handsomehhj/lcdc/epson/s1d13700/dev/branches/customer/truly/hw/brd/pdf/s1d13700_bom.xlsx

HOST I/F Revised: Thursday, August 09, 2012
HHJ-LCDC-2012001 Revision: 0.1
Bill Of Materials October 15,2012 15:38:38 | Page1
Item | Quantity | Reference | Part | Package
______________________________________________
Main |  | Main
1 | 1 | J1 | CON18 | TBD | 主机接口-插针
2 | 2 | R6,R7 | DNC | 0603
3 | 7 | R9,R12,R21,R41,R42,R43,R45 | DNC | 0603
4 | 27 | C1,C2,C7,C9,C11,C12,C13,C14,C15,C16,C17,C18,C19,C20, C21,C22,C23,C24,C25,C26,C27,C28,C29,C30,C31,C32,C33 | 0.1uF | 0603 |  | 电压/10V
5 | 2 | C8,C10 | 10uF | 1206 |  | 电压/10V
6 | 1 | D1 | LED_G | 0603 | LED Green | 绿色
7 | 2 | R1,R22 | 10K | 0603 |  | 精度？1%
8 | 3 | R2,R4,R5 | 33 | 0603 |  | 精度？1%
9 | 10 | R8,R10,R11,R13,R15,R16,R17,R18,R19,R20 | 0 | 0603
10 | 16 | R14,R23,R24,R25,R26,R27,R28,R29,R30,R31,R32,R33,R34, R35,R36,R37 | 4.7K | 0603 |  | 精度？1%
11 | 1 | U4 | SG8002 |  | 10MHz振荡器
12 | 1 | U6 | S1D13700
13 | 1 | U5 | TLV70012 | SOT23-5 | 1.2V LDO |  | Texas Itruments
14 | 1 | U7 | XC3S50A-4VQG100C | VQFP100 | FPGA 100 pin |  | Xilinx Inc
15 | 1 | U8 | SST25VF010 | SOIC-8 | Flash |  | MICROCHIP
3V/5V I/F
16 | 2 | U1,U2 | SN74AC245 | TSSOP20 |  |  | Texas Itruments
17 | 1 | U3 | LM1117-3.3V | SOT223 |  |  | National Semiconductor
18 | 2 | C3,C5 | 10uF | 1206 |  | 电压？10V
19 | 2 | C4,C6 | 0.1uF | 0603 |  | 10V
20 | 1 | R3 | 0 | 0603
Backlight
21 | 1 | L1 | 10uH | 1210 |  | 绕线
22 | 3 | R38,R39,R40 | 1.1 | 0603 |  | 精度？1%
23 | 2 | C36,C37 | 4.7uF | 1206 |  | 电压？10V
24 | 1 | D2 | MBR0530T1G | SOD123 |  |  | ON Semiconductor
25 | 1 | U9 | SP1072 | SOT123-6
26 | 1 | C34 | 0.1uF | 0603 |  | 电压？10V
27 | 1 | J4 | CON6 | TBD | BackLight I/F
28 | 1 | J3 | TM057KDH01 | TBD | LCD I/F
