handsomehhj/lcdc/epson/s1d13700/dev/branches/customer/truly/hw/brd/pdf/s1d13700.pdf

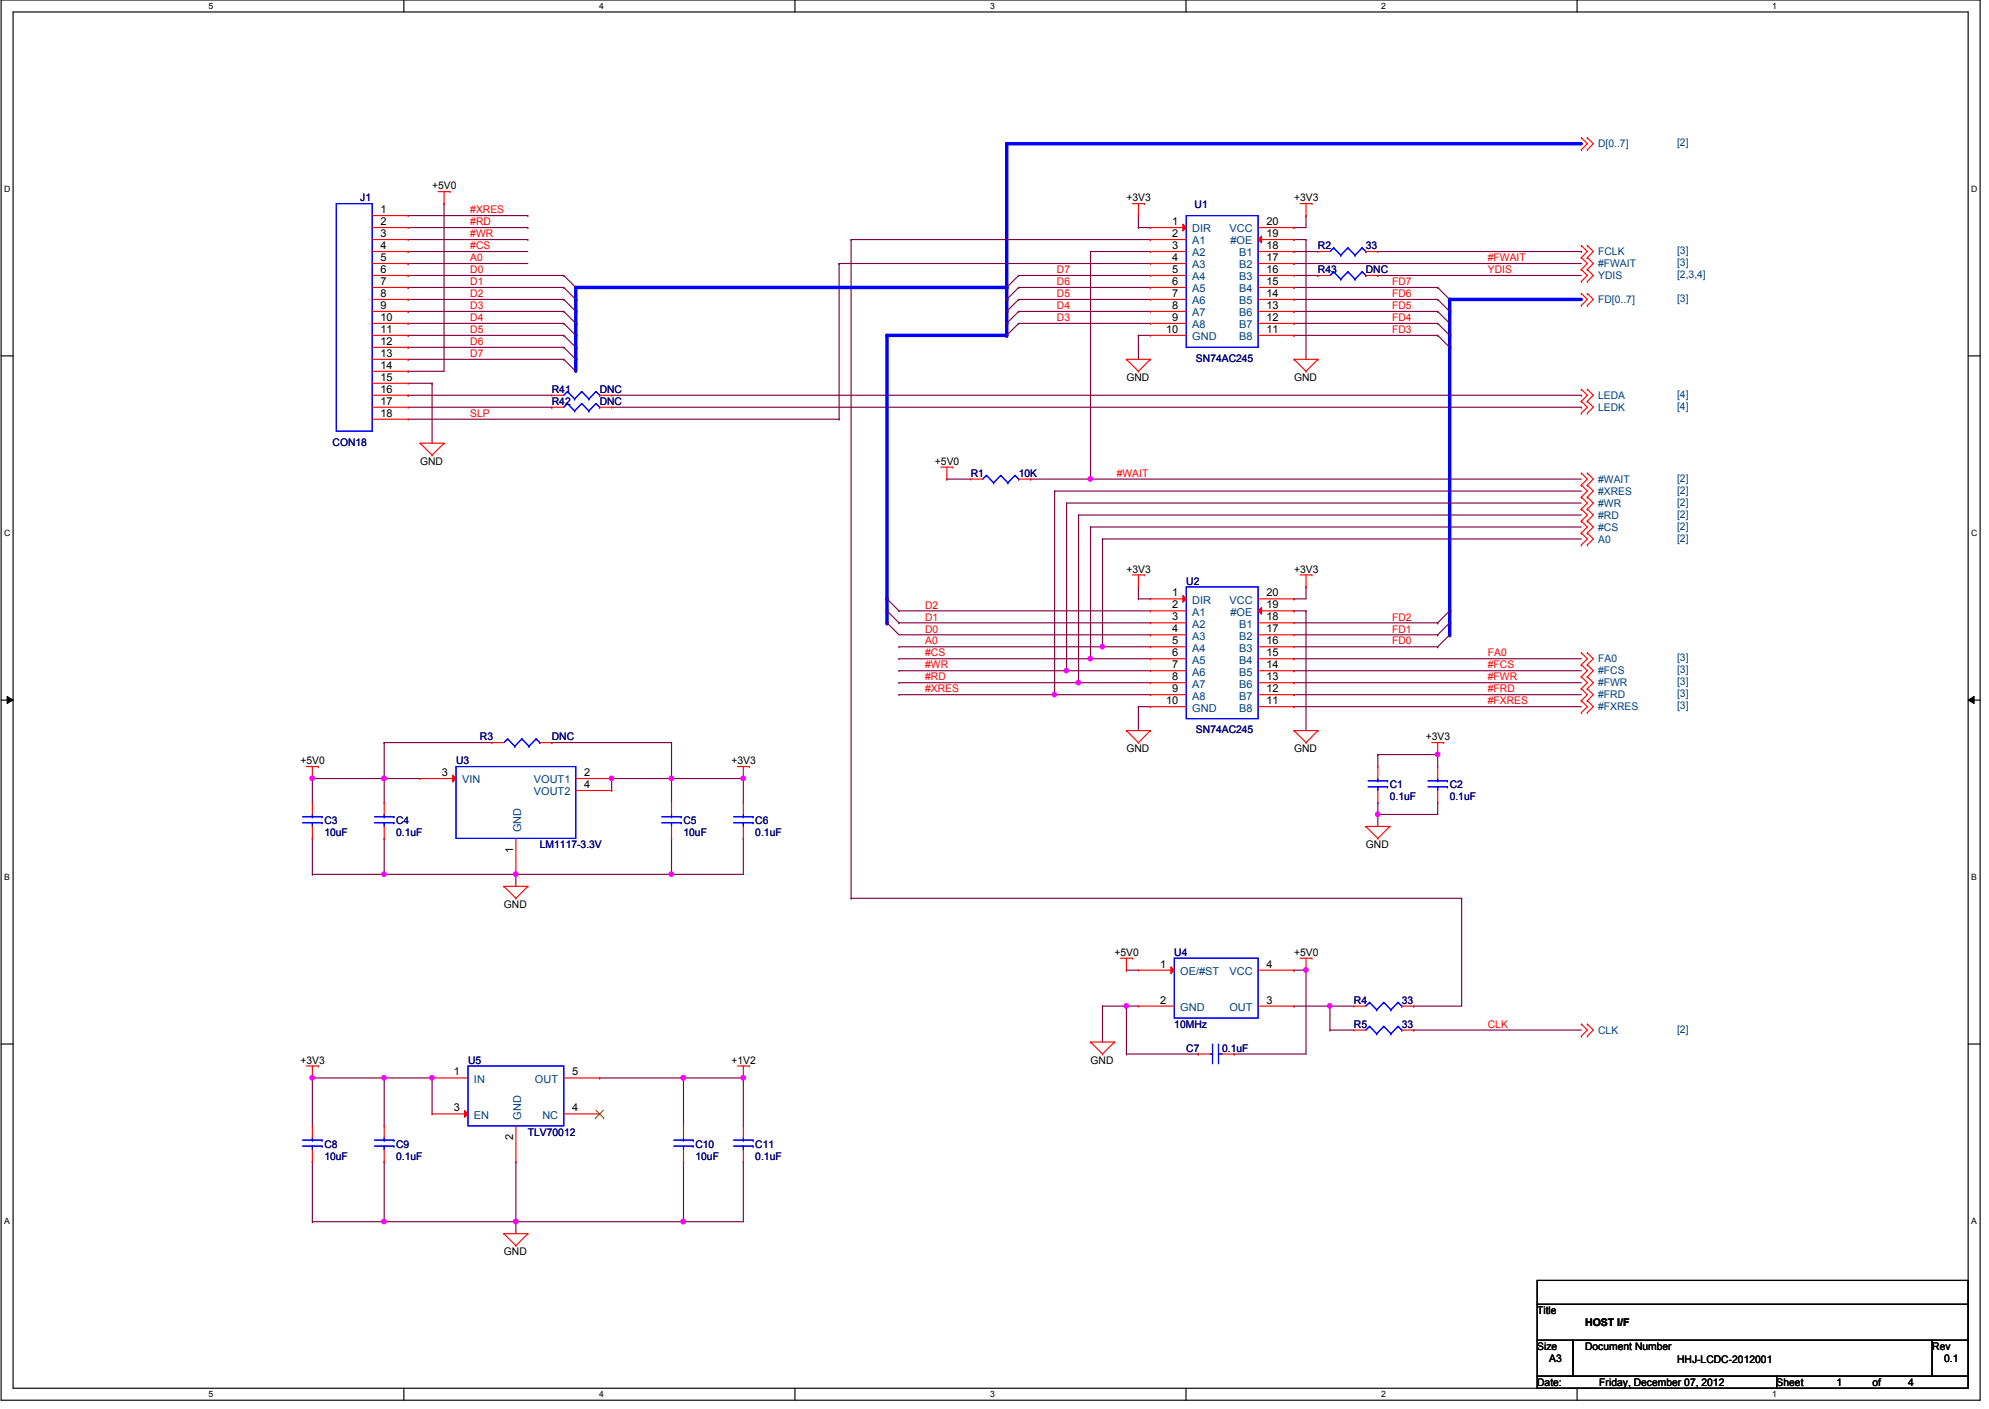
[picture p1: page 1]

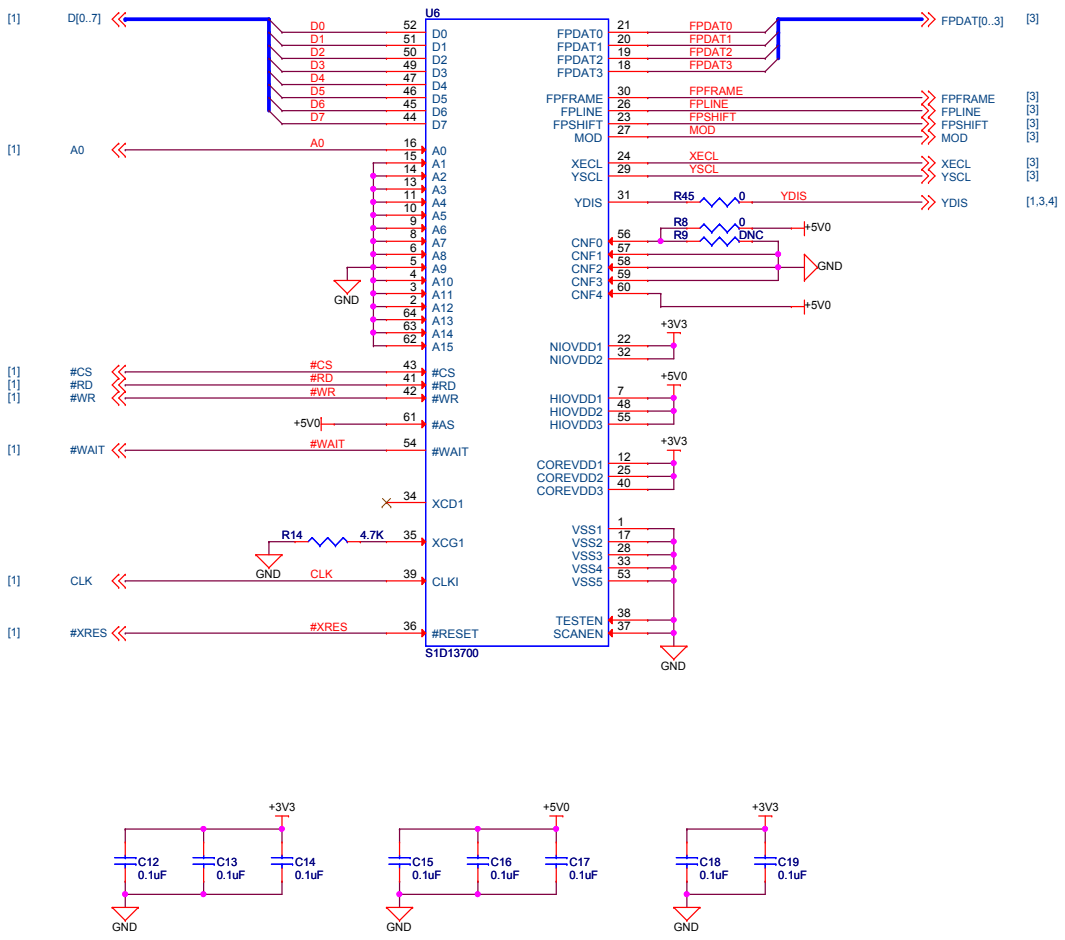
[picture p2: page 2]

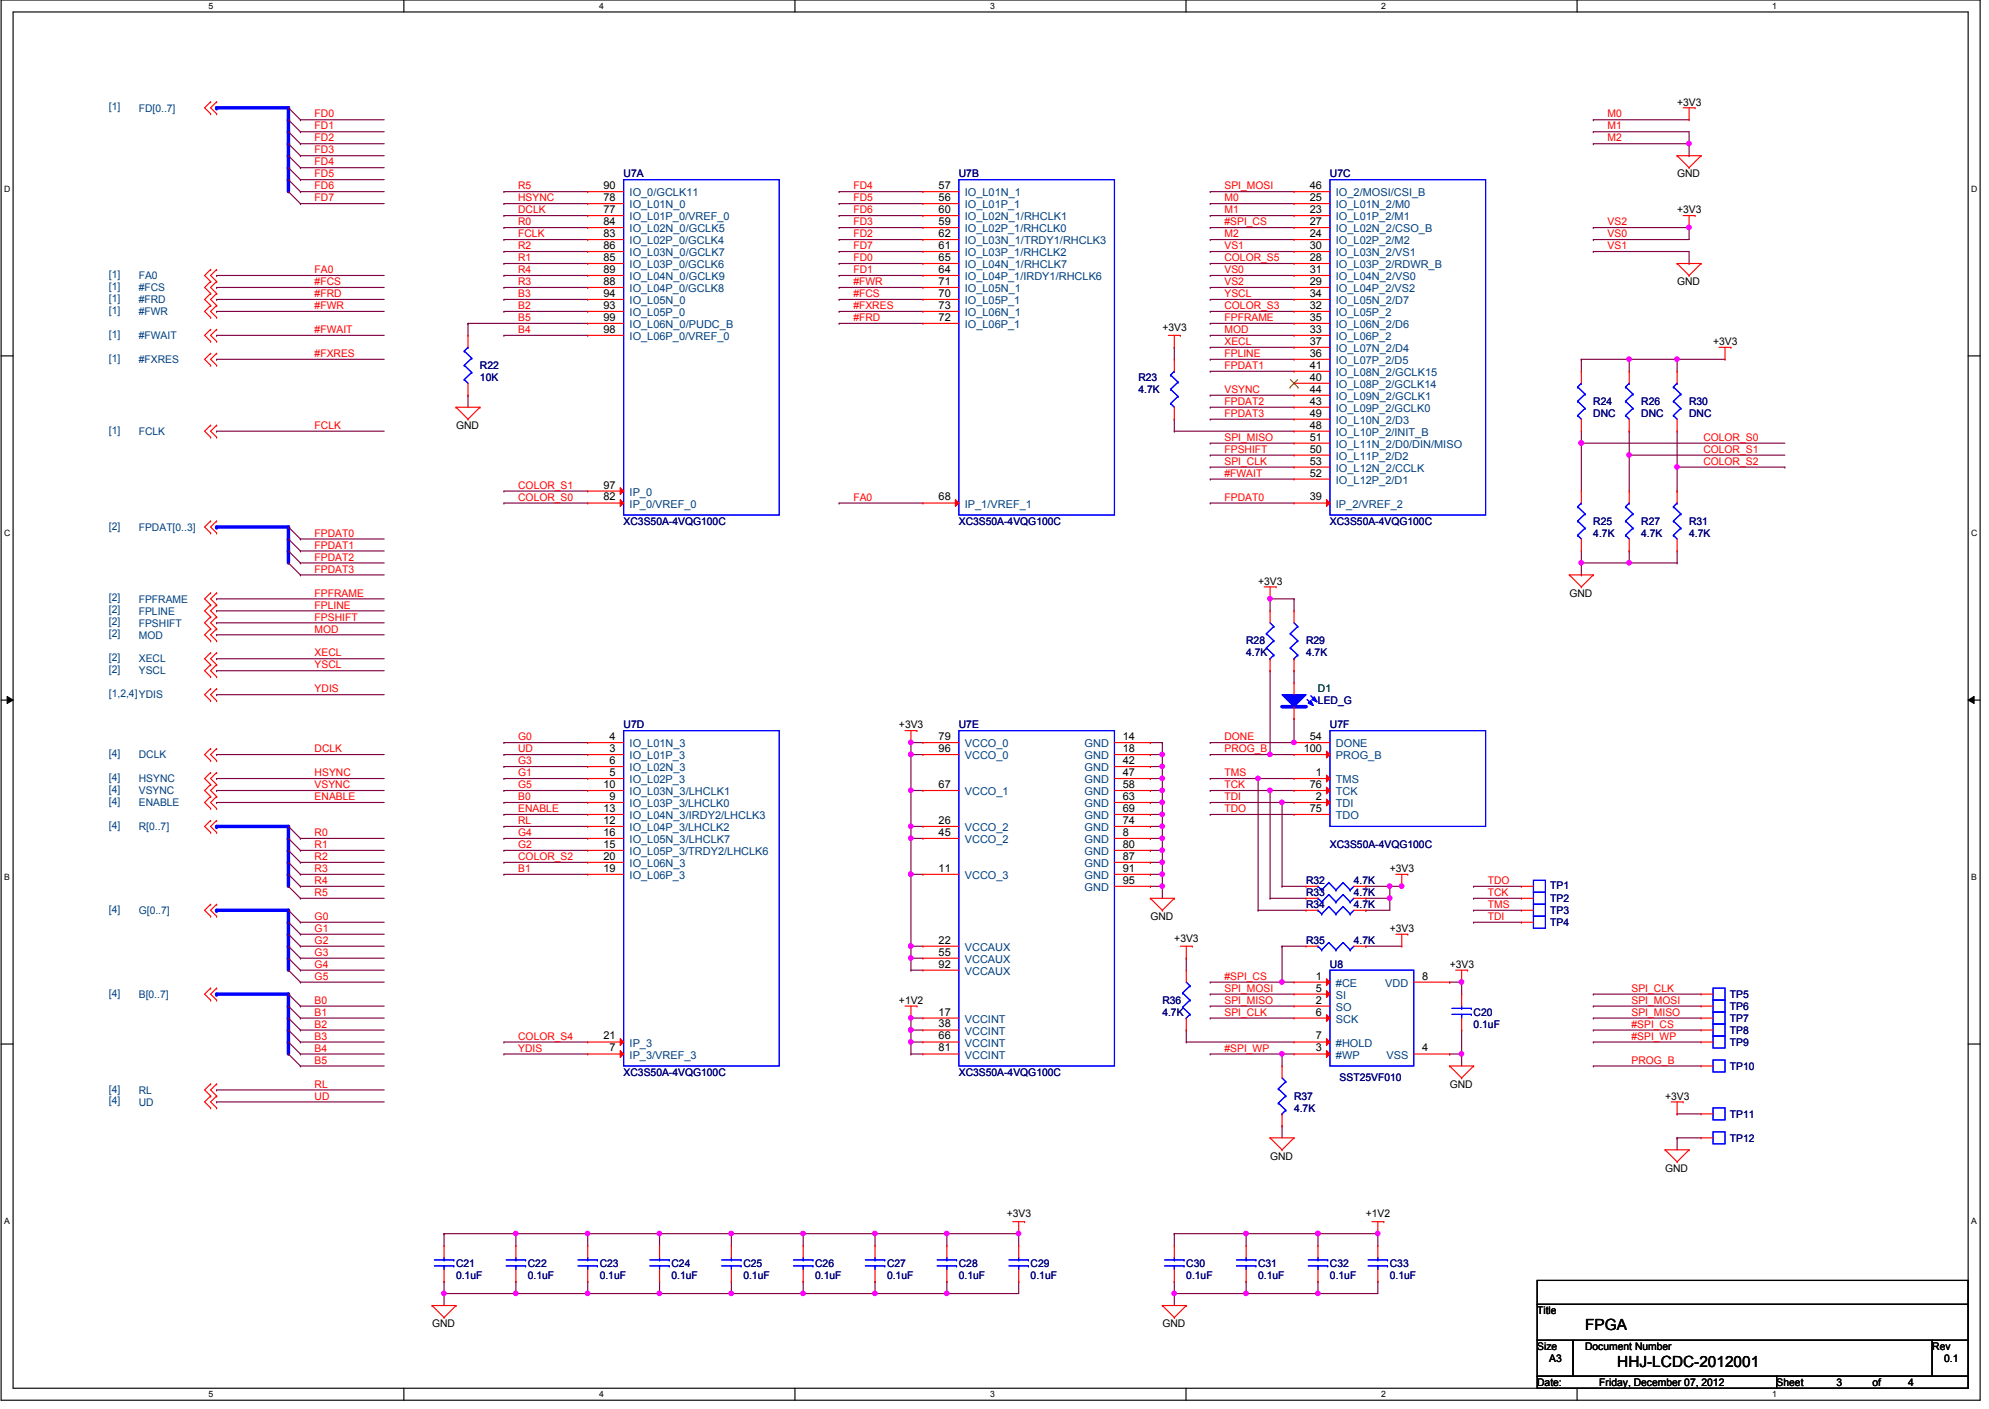
[picture p3: page 3]

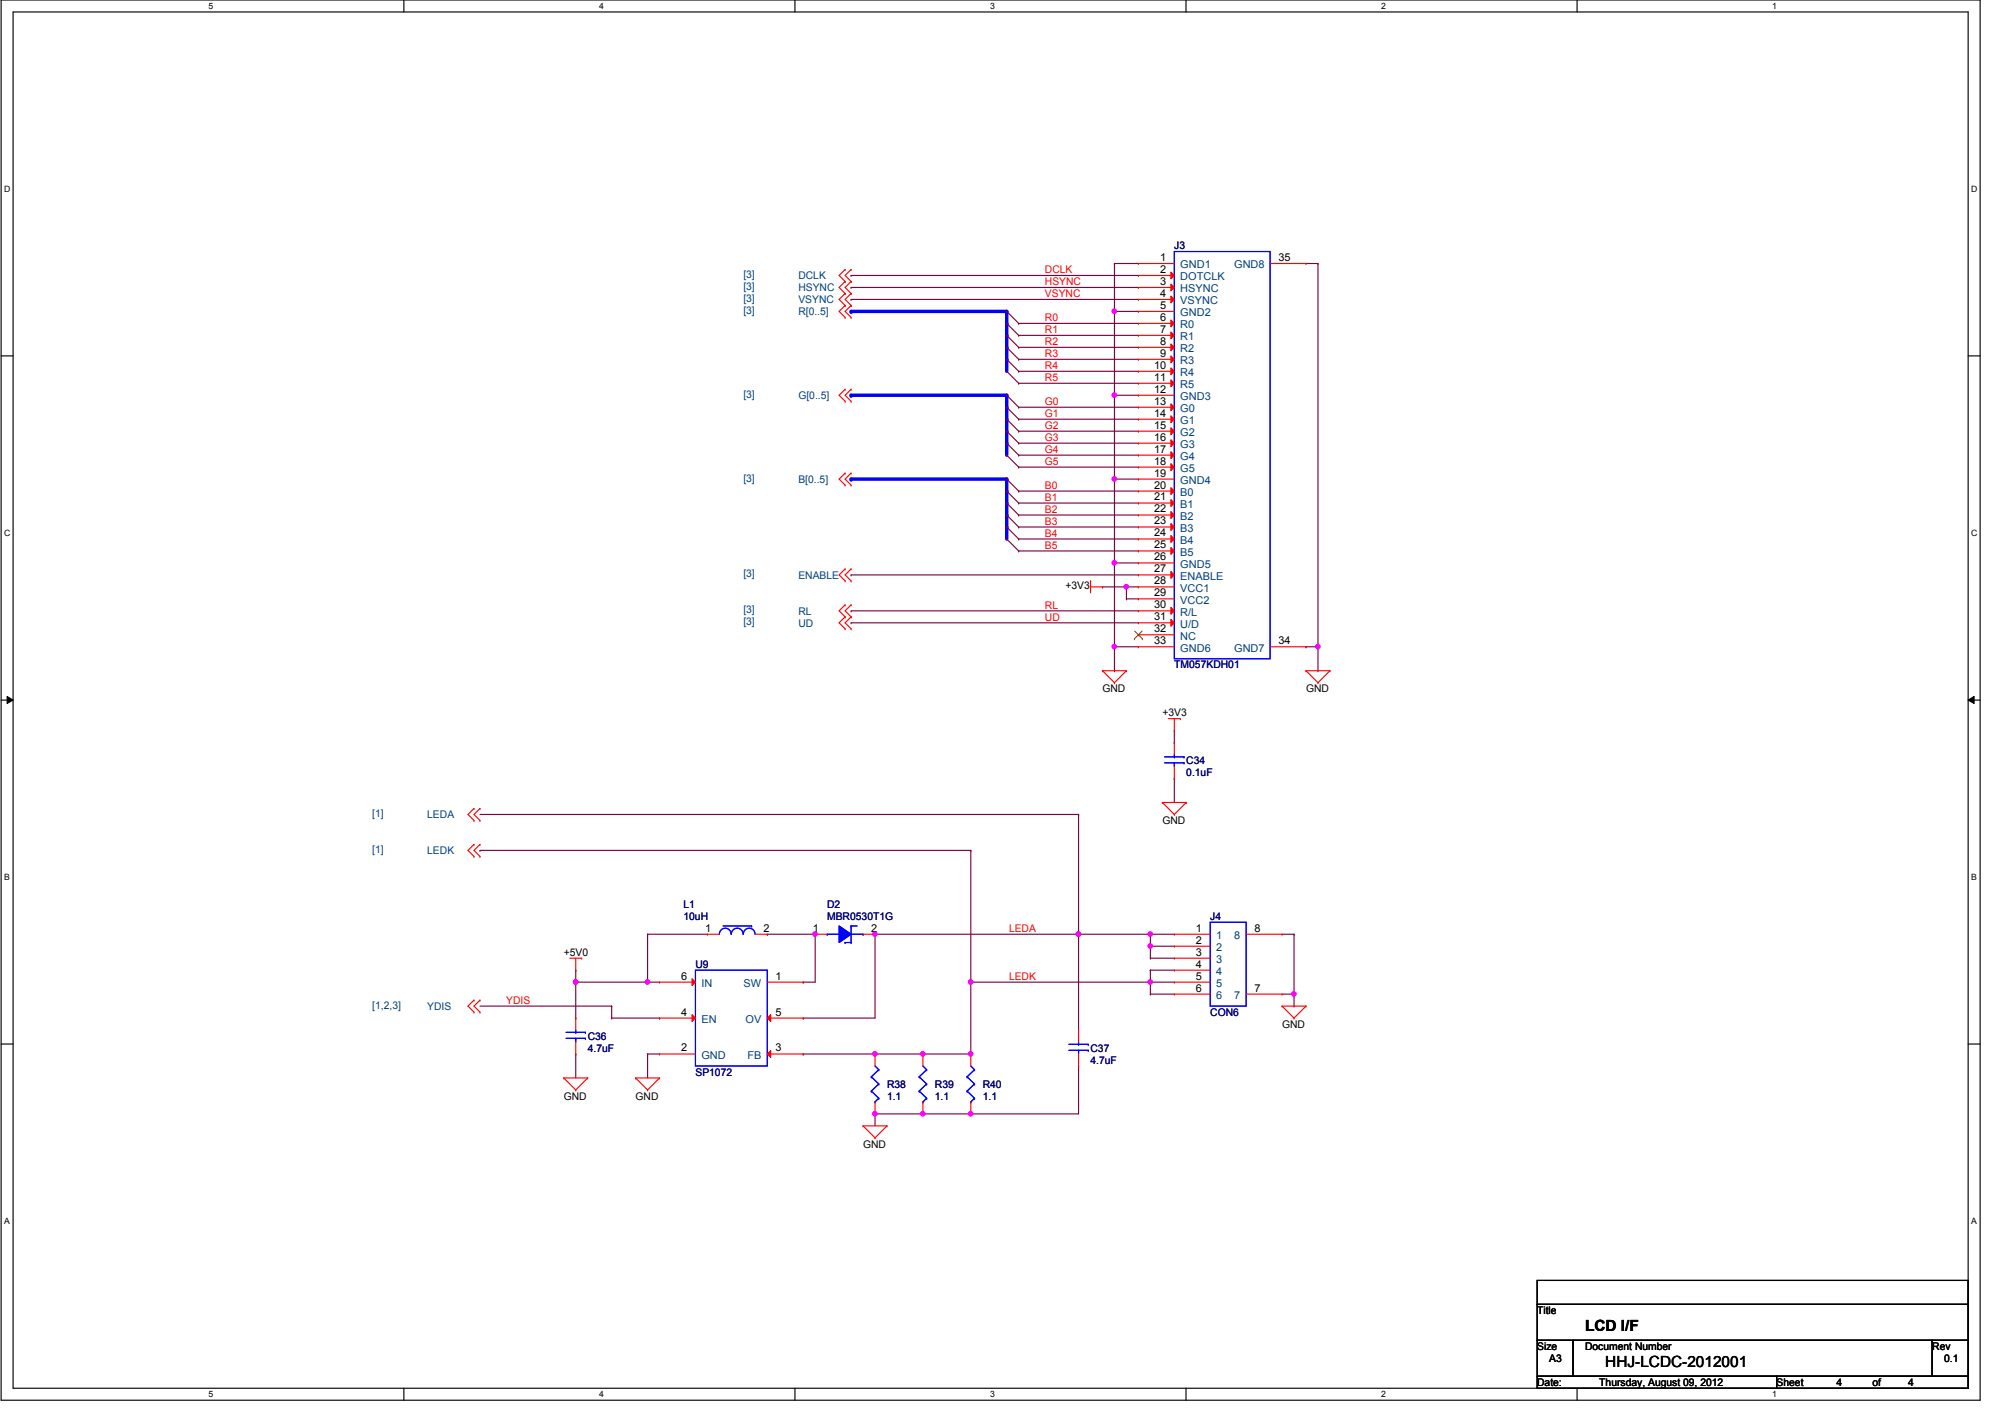
[picture p4: page 4]
