handsomehhj/lcdc/(list of files, drawings)

Other design files:
epson/s1d13700/dev/branches/customer/truly/hw/brd/sch/S1D13700.DSN
epson/s1d13700/dev/branches/customer/truly/hw/brd/sch/s1d13700.opj
epson/s1d13700/dev/release/201303030954/hw/brd/sch/S1D13700_LOWVERSION.DSN
