handsomehhj/lcdc/epson/s1d13700/dev/branches/customer/truly/hw/brd/pcb/gerber/art_param.txt

DEVICE-TYPE           GERBER_RS274X
OUTPUT-UNITS          INCHES
FILM-SIZE             2800000 1600000
FORMAT                5.5
ABORT-ON-ERROR        NO
SCALE                 1
SUPPRESS-LEAD-ZEROES  YES
SUPPRESS-TRAIL-ZEROES NO
SUPPRESS-EQUAL        YES
UNDEF-APT-CONT        NO
