handsomehhj/lcdc/(commit log)

2012-11-05 New creation.
    [S1D13700.DSN, art_param.txt, nc_param.txt, s1d13700.brd, s1d13700.opj, s1d13700_bom.xlsx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]
2012-11-11 Add monitor design. The host access can be transfer to the PC via the serial port.
    [s1d13700.opj, s1d13700_bom.xlsx]
2012-11-11 New release (RTL still contains bug).
    [S1D13700.DSN, s1d13700.brd, s1d13700.opj, s1d13700_bom.xlsx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]
2012-11-19 Still remain flicker problem.
    [S1D13700.DSN, s1d13700.brd, s1d13700.opj, s1d13700_bom.xlsx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]
2012-11-19 Add branches
    [S1D13700.DSN, art_param.txt, nc_param.txt, s1d13700.brd, s1d13700.opj, s1d13700_bom.xlsx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]
2012-11-19 Move to dev directory.
    [S1D13700.DSN, art_param.txt, nc_param.txt, s1d13700.brd, s1d13700.opj, s1d13700_bom.xlsx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]
2012-11-19 Using separate frame buffer solution to avoid register setting problem.
2012-11-19 Branches current design for separate solution base.
    [S1D13700.DSN, art_param.txt, nc_param.txt, s1d13700.brd, s1d13700.opj, s1d13700_bom.xlsx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]
2012-12-07 Update to fix current bug.
    [S1D13700.DSN, s1d13700.opj]
2012-12-11 For customer, to solve flash issue.
    [tft_tg.v]
2012-12-26 Branch for pin assignment testing.
2012-12-27 Add tianma customer branch.
    [S1D13700_LOWVERSION.DSN]
2012-12-28 1. Update DSN from tianma. 2. Testing pin assignment changing.
    [S1D13700_LOWVERSION.DSN]
2012-12-28 Add new release (Fixed version, still a little bit flicker). Remove hw directory.
    [S1D13700.DSN, s1d13700.brd, s1d13700.opj, s1d13700_bom.xlsx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]
2012-12-28 Updated for format changing.
    [S1D13700.DSN, s1d13700.opj]
2012-12-28 Fixed version for release.
    [S1D13700.DSN, s1d13700.brd, s1d13700.opj, s1d13700_bom.xlsx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]
2012-12-28 Branch for truly.
    [S1D13700.DSN, art_param.txt, nc_param.txt, s1d13700.brd, s1d13700.opj, s1d13700_bom.xlsx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]
2013-03-03 Modify pin assignment.
2013-03-03 Add release for tianma (Tianma's board)
    [S1D13700_LOWVERSION.DSN]
2013-05-29 Support truly board.
